HoodPaul/amiga-4000d-ide-expansion/docs/README.md

# Documentation index

| Guide | Purpose |
|---|---|
| [AI-HANDOVER.md](AI-HANDOVER.md) | Current state, authoritative files and next actions |
| [ASSEMBLY.md](ASSEMBLY.md) | Connector selection, fitting, diode orientation and first tests |
| [ELECTRICAL.md](ELECTRICAL.md) | Bus arrangement and intentional pin exceptions |
| [MECHANICAL.md](MECHANICAL.md) | Dimensions, connector positions and fit checks |
| [FABRICATION.md](FABRICATION.md) | PCB settings and submission record |
| [layer-file-map.txt](layer-file-map.txt) | Four-layer Gerber ordering |
| [VALIDATION.md](VALIDATION.md) | Completed CAD checks and hardware validation boundary |
| [HARDWARE-TEST-LOG.md](HARDWARE-TEST-LOG.md) | Pending physical and functional checks |
| [../source/WORKFLOW.md](../source/WORKFLOW.md) | Editing, checking and candidate exports |

The root README is the project overview. The current handover is the entry point
for engineering continuation. Use each guide for the details it owns.
