HoodPaul/amiga-4000d-ide-expansion/verification/drc_report.txt

** Drc report for Amiga4000_IDE_Expansion.kicad_pcb **
** Created on 2026-10-26 20:16:41 **

** Found 0 DRC violations **

** Found 0 unconnected pads **

** Found 0 Footprint errors **

** End of Report **
