HoodPaul/amiga-4000d-ide-expansion/docs/Fit_Check_1to1_A4.pdf

# Amiga 4000D IDE Expansion

Revision 0.1 - full-size mechanical fit drawing

Print at 100% / Actual size. Disable Fit, Shrink and page scaling.

Measure the 100 mm calibration bar before using the drawing.
Top view. J1 and J4 are fitted to the underside.
Disconnect the Amiga from power before checking alignment.

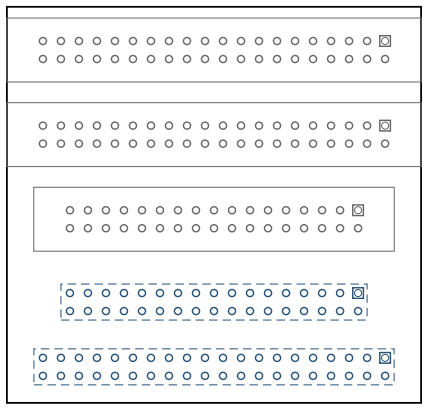
[picture p3: figure]

J3 top IDE B

J2 top IDE A

J5 top floppy

J4 bottom floppy

J1 bottom IDE

Board outline: 58.42 x 55.88 mm

Motherboard socket centre spacing: 9.144 mm. Pin and row pitch: 2.54 mm.

Both socket centres are 29.210 mm from the left board edge.

J1 and J4 need equal mating heights. Check the selected connector datasheets.

Check underside diode clearance, nearby components, drive cage and cable plugs.

Body rectangles are nominal guides. Pads and centres define the planned alignment.

100 mm calibration bar

0 | 10 | 20 | 30 | 40 | 50 | 60 | 70 | 80 | 90 | 100

This paper drawing does not verify assembled height or fit on a particular motherboard.

Revision 0.1 PCB submitted for fabrication. Physical fit and operation remain untested.

Prepared 26 October 2026. Use the repository assembly and mechanical guides.
