HoodPaul/amiga-4000d-ide-expansion/BOM.csv

Reference | Quantity per PCB | Part | Package / pitch | Fitted side | Notes
PCB1 | 1 | Amiga 4000D IDE Expansion REV 0.1 | 58.42 x 55.88 mm |  | 4-layer FR-4; black mask; white silkscreen; 1.6 mm nominal
J1 | 1 | 40-contact female PCB socket | 2 x 20; 2.54 mm row and column pitch | Bottom | Vertical solder-tail socket; same mating height as J4
J2 / J3 | 2 | 40-pin male IDC box header | 2 x 20; 2.54 mm row and column pitch | Top | Vertical shrouded header; nominal body length 58.46 mm; check actual datasheet
J4 | 1 | 34-contact female PCB socket | 2 x 17; 2.54 mm row and column pitch | Bottom | Vertical solder-tail socket; same mating height as J1
J5 | 1 | 34-pin male IDC box header | 2 x 17; 2.54 mm row and column pitch | Top | Vertical shrouded header
D1 / D2 | 2 | 1N4148 | DO-35 / SOD27; 7.62 mm formed lead spacing | Bottom | Cathode bands to pad 1 / K; both cathodes connect to J1 pin 31
