HoodPaul/amiga-4000d-ide-expansion/docs/HARDWARE-TEST-LOG.md

# Hardware test log

Revision 0.1. Last updated 26 October 2026. No hardware results recorded.

| Check | Status | Evidence / result |
|---|---|---|
| PCB submitted for fabrication | Reported by Paul, 26 October 2026 | Final revision 0.1 manufacturing ZIP retained |
| PCB received and inspected | Pending | |
| Finished outline and thickness measured | Pending | |
| Connector part numbers and mating heights | Pending | |
| Bare-board continuity and short checks | Pending | |
| Diode orientation and diode-mode tests | Pending | |
| Simultaneous J1/J4 motherboard fit | Pending | |
| Diode, drive-cage and cable clearance | Pending | |
| Primary master boot and read/write test | Pending | |
| Floppy pass-through | Pending | |
| Secondary master with compatible driver | Pending | |
| Primary master/slave pair | Pending | |
| Secondary master/slave pair | Pending | |
| Four-device operation and cold/warm resets | Pending | |
| Extended transfer and integrity checks | Pending | |

For each functional result record date, tester, motherboard revision, CPU card,
PSU, AmigaOS and driver versions, device models, master/slave settings, cable
lengths, test method, duration and outcome. Record failures as well as successes.
