HoodPaul/amiga-4000d-ide-expansion/verification/pin_connections.csv

Net | Connected physical pins
B_CSEL_NC | J3.28
B_PDIAG_NC | J3.34
FD_02 | J4.2; J5.2
FD_03 | J4.3; J5.3
FD_04 | J4.4; J5.4
FD_06 | J4.6; J5.6
FD_08 | J4.8; J5.8
FD_10 | J4.10; J5.10
FD_12 | J4.12; J5.12
FD_14 | J4.14; J5.14
FD_16 | J4.16; J5.16
FD_18 | J4.18; J5.18
FD_20 | J4.20; J5.20
FD_22 | J4.22; J5.22
FD_24 | J4.24; J5.24
FD_26 | J4.26; J5.26
FD_28 | J4.28; J5.28
FD_30 | J4.30; J5.30
FD_32 | J4.32; J5.32
FD_34 | J4.34; J5.34
GND | J1.2; J1.19; J1.22; J1.24; J1.26; J1.30; J1.40; J2.2; J2.19; J2.22; J2.24; J2.26; J2.30; J2.40; J3.2; J3.19; J3.22; J3.24; J3.26; J3.30; J3.40; J4.1; J4.5; J4.7; J4.9; J4.11; J4.13; J4.15; J4.17; J4.19; J4.21; J4.23; J4.25; J4.27; J4.29; J4.31; J4.33; J5.1; J5.5; J5.7; J5.9; J5.11; J5.13; J5.15; J5.17; J5.19; J5.21; J5.23; J5.25; J5.27; J5.29; J5.31; J5.33
IDE_CSEL28 | J1.28; J2.28
IDE_CS_A_n | J1.37; J2.37
IDE_CS_B_n | J1.38; J3.37
IDE_D0 | J1.4; J2.4; J3.4
IDE_D1 | J1.6; J2.6; J3.6
IDE_D10 | J1.13; J2.13; J3.13
IDE_D11 | J1.11; J2.11; J3.11
IDE_D12 | J1.9; J2.9; J3.9
IDE_D13 | J1.7; J2.7; J3.7
IDE_D14 | J1.5; J2.5; J3.5
IDE_D15 | J1.3; J2.3; J3.3
IDE_D2 | J1.8; J2.8; J3.8
IDE_D3 | J1.10; J2.10; J3.10
IDE_D4 | J1.12; J2.12; J3.12
IDE_D5 | J1.14; J2.14; J3.14
IDE_D6 | J1.16; J2.16; J3.16
IDE_D7 | J1.18; J2.18; J3.18
IDE_D8 | J1.17; J2.17; J3.17
IDE_D9 | J1.15; J2.15; J3.15
IDE_DA0 | J1.35; J2.35; J3.35
IDE_DA1 | J1.33; J2.33; J3.33
IDE_DA2 | J1.36; J2.36; J3.36
IDE_DASPn | J1.39; J2.39; J3.39
IDE_IORn | J1.25; J2.25; J3.25
IDE_IOWn | J1.23; J2.23; J3.23
IDE_IRQ_A | J2.31; D1.2
IDE_IRQ_B | J3.31; D2.2
IDE_IRQ_HOST | J1.31; D1.1; D2.1
IDE_KEY20 | J1.20; J2.20; J3.20
IDE_NC21 | J1.21; J2.21; J3.21
IDE_NC27 | J1.27; J2.27; J3.27
IDE_NC29 | J1.29; J2.29; J3.29
IDE_NC32 | J1.32; J2.32; J3.32
IDE_PDIAG34 | J1.34; J2.34
IDE_RESETn | J1.1; J2.1; J2.38; J3.1; J3.38
