HoodPaul/amiga-4000d-ide-expansion/previews/Schematic.pdf

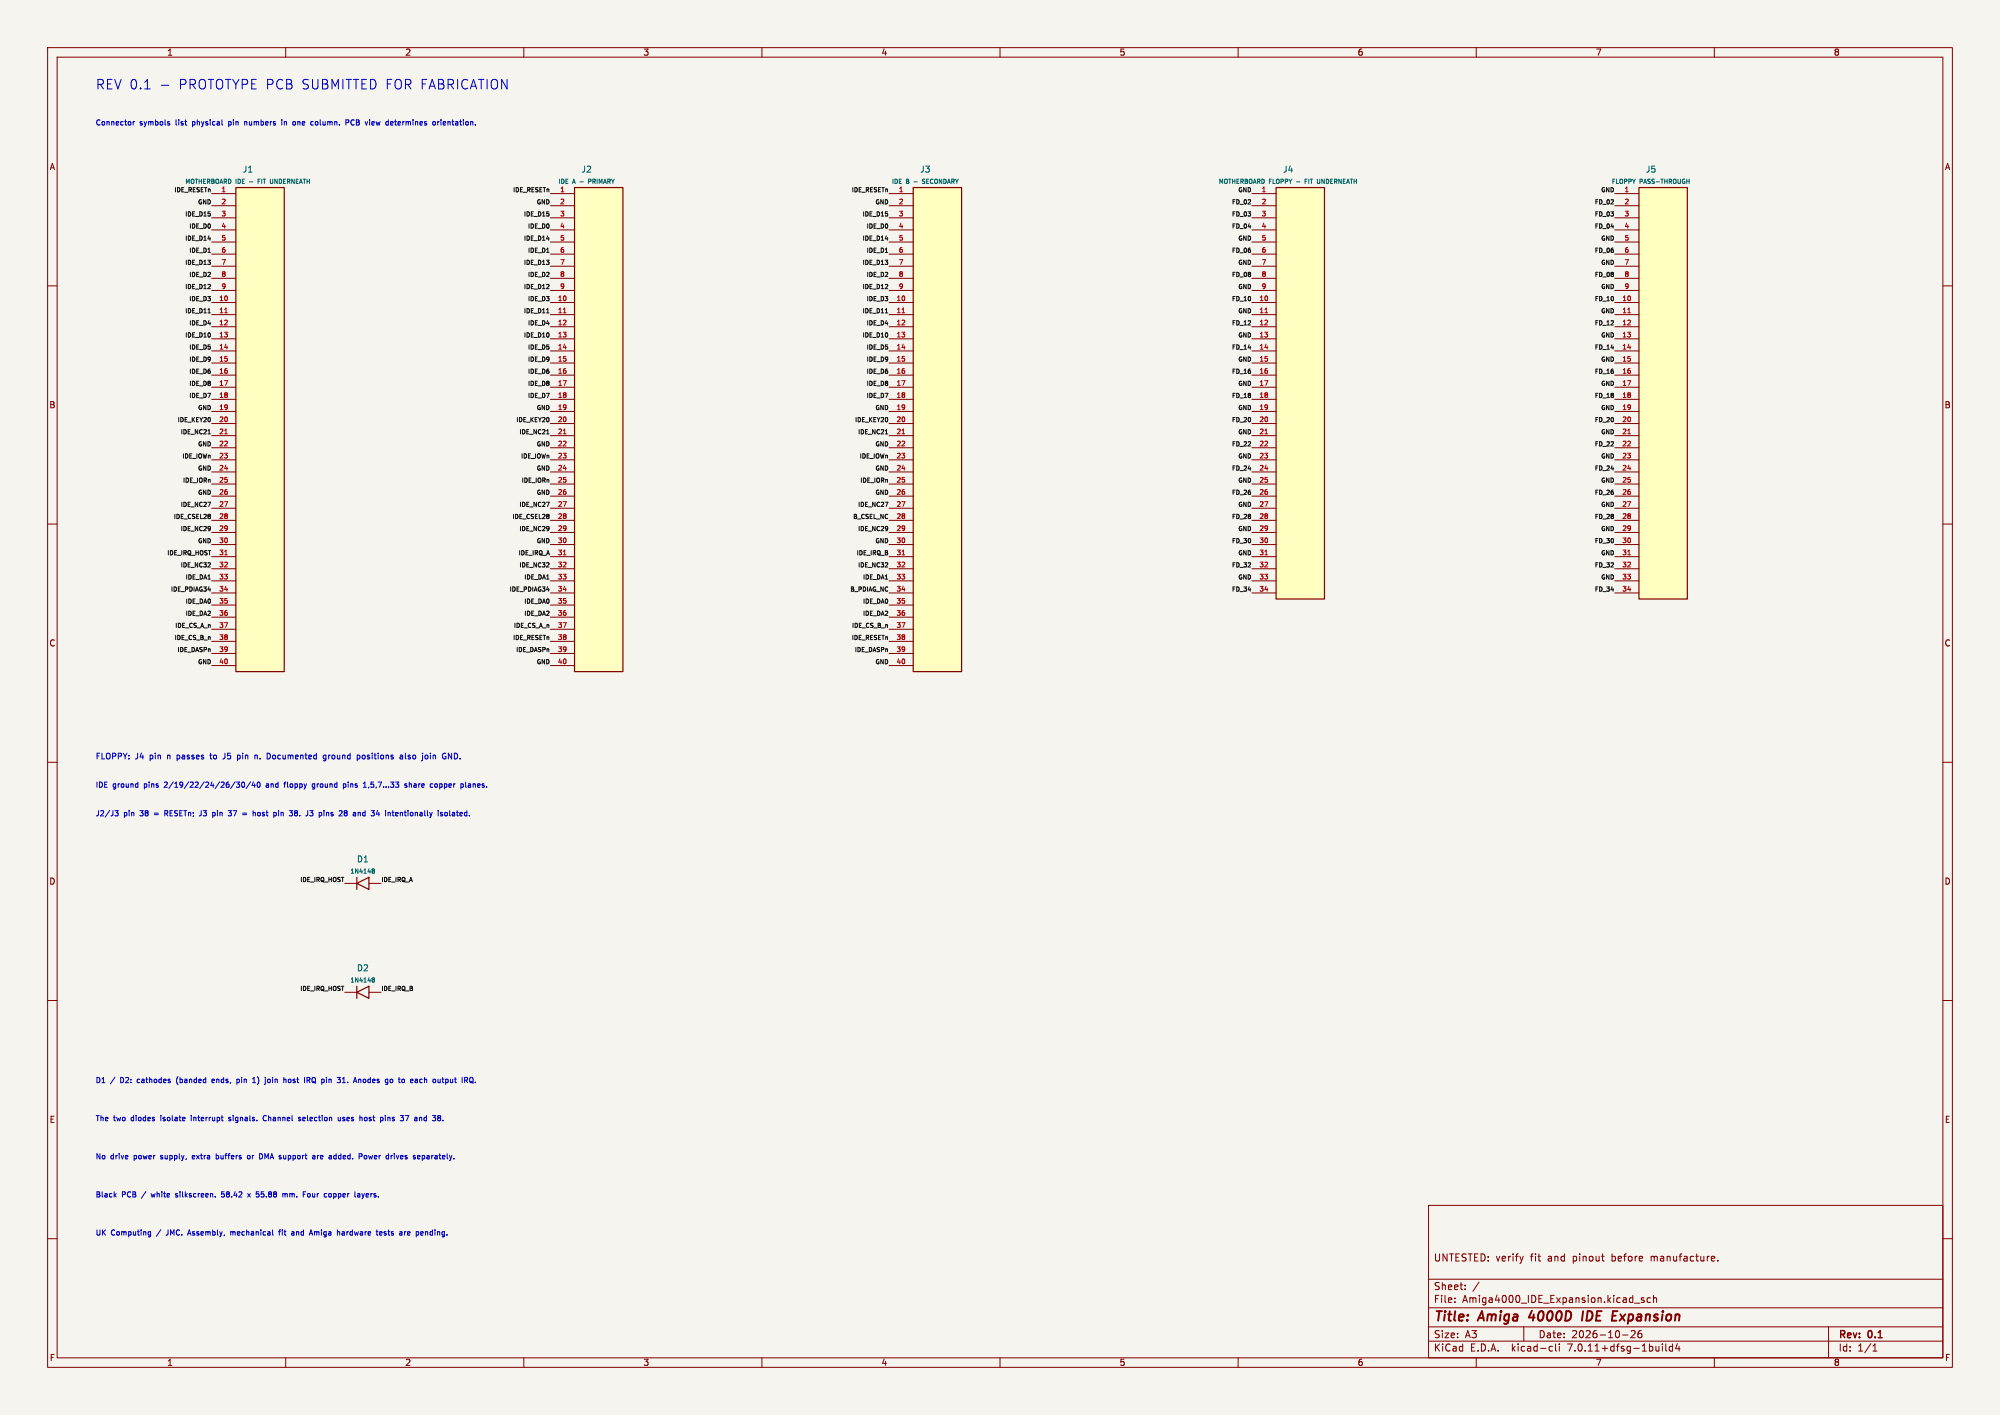
[picture p4: page 1]

REV 0.1 - PROTOTYPE PCB SUBMITTED FOR FABRICATION

Id: 1/1 Title: Amiga 4000D IDE Expansion
